dev-pradeep-singh/BusSim/Core/Inc/main.h

#define LED_Pin GPIO_PIN_13
#define LED_GPIO_Port GPIOC
#define LIN_CS_Pin GPIO_PIN_1
#define LIN_CS_GPIO_Port GPIOB
#define CAN_RX_Pin GPIO_PIN_8
#define CAN_RX_GPIO_Port GPIOB
#define CAN_TX_Pin GPIO_PIN_9
#define CAN_TX_GPIO_Port GPIOB
